duplico/qc10/hardware/QC10 BOM.xlsx

Sheet: BOM 2A
QTY | Reference | Part | Package | Manufacturer | PN | Any? | Notes
1 | A1 | ANT | 5.1mm SMT | Linx | ANT-433-USP | N
1 | BT1 | AAA | 0.5 in | Keystone | 2479 | Y
1 | C1 | 2.2uF | 3216 (mm) | Kemmet | T491A225K016AT | Y
1 | C14 | 4.7nF | 3216(mm) | Vishay | VJ1206Y472KXQCW1BC | Y
2 | C15, R15 | 0 Ohm | 3216 (mm) | Vishay | CRCW12060000Z0EA | Y
1 | C2 | 10nF | 0603 (mm) | Kemmet | C0201C103K4PACTU | Y
1 | C3 | 220pF | 0603 (mm) | TDK | C0603X7R1E221M030BA | Y
1 | C5 | 47uF | 6.3 mm x 5.4 mm | Kemet | EEV476M035A9GAA | Y
1 | C4 | 0.1uF | 0603 (mm) | Kemet | T491A104M035AT | Y
8 | C6 - C13 | 0.1uF | 3216(mm) | Vishay | VJ1206Y104KXQCW1BC | Y
3 | D1, D7, D14 | Red LED | 0603 (mm) | Lite-On | LTST-C193KRKT-5A | Y
1 | D13 | RGB LED | PLCC-6 | Avago | ASMT-YTB2-0BB02 | Y
1 | D15 | 0.5A | 3216(mm) | Schottky | SD1206S040S | Y
2 | D2, D8 | Ong LED | 0603 (mm) | Lite-On | LTST-C193KFKT-5A | Y
2 | D3, D9 | Yel LED | 0603 (mm) | Lite-On | LTST-C193KSKT-5A | Y
2 | D4, D10 | Grn LED | 0603 (mm) | Lite-On | LTST-C193KGKT-5A | Y
2 | D5, D11 | Blu LED | 0603 (mm) | Lite-On | LTST-C194TBKT | Y
2 | D6, D12 | Pink LED | 0603 (mm) | Panasonic | LNJP12X8ARA | N
0 | L1 |  | 1608 (mm) | Taiyo Yuden | HK16083N9S-T | Y | DNP/DNI
1 | MK1 | 2.2k | 4mm | PUI | TOM-1545P-R | N
2 | P1, P2 | 2x8 | 2 mm | 3M | 961208-6404-AR | Y | DNI
1 | P3 | 1x8 | 2mm | Harwin | M22-2010846 | Y | DNI
1 | R1 | 10k | 3216 (mm) | Vishay | CRCW120610K0FKEA | Y
3 | R2, R3, R4 | 2.2k | 3216 mm | Vishay | CRCW12062K20FKEA | Y
1 | U1 | Atmel MCU | TQFP-32 | Atmel | ATmega328P-AU | N
1 | U2 | 433Mhz | SOP-14 | HopeRF | RFM12B-433S2 | N | Customer Supplied
1 | U3 | LED Controler | HTSSOP-28 | TI | TLC5940PWP | N
1 | U4 | 22db Amp | SC-70 | Maxim | MAX9812 | N
1 | VR1 | 3.3v Reg | SOT 223-4 | TI | UA78M05CDCYR | Y
1 | X1 | 16 MHz Xt | 5mm | ECS | X908-ND | N

Sheet: Copy of Sheet1
Designator | Manufacturer | PN | Footprint | QTY | Price | Price QTY | Extended Pice | Voltage | Current | Power | Notes
U1 | Atmel | ATmega328P-AU | TQFP-32 | 1 | 1.73 | 100 | 1.73
U2 | HopeRF | RFM12B-433S2 | SOP-14 | 1 | 3.3 | 100 | 3.3
U3 | TI | TLC5940PWP | HTSSOP-28 | 1 | 1.82 | 100 | 1.82
D1, D7, D14 | Lite-On | LTST-C193KRKT-5A | 0603 (mm) | 3 | 0.078 | 100 | 0.234 | 1.85 |  |  | 10mcd
D2, D8 | Lite-On | LTST-C193KFKT-5A | 0603 (mm) | 2 | 0.25 | 100 | 0.5 | 1.95 |  |  | 21mcd
D3, D9 | Lite-On | LTST-C193KSKT-5A | 0603 (mm) | 2 | 0.25 | 100 | 0.5 | 1.95 |  |  | 16mcd, Amber
D4, D10 | Lite-On | LTST-C193KGKT-5A | 0603 (mm) | 2 | 0.65 | 100 | 1.3 | 2.9 |  |  | 40mcd
D5, D11 | Lite-On | LTST-C194TBKT | 0603 (mm) | 2 | 0.42 | 100 | 0.84 | 2.9 |  |  | 11.5mcd
D6, D12 | Panasonic | LNJP12X8ARA | 0603 (mm) | 2 | 0.32 | 100 | 0.64 | 2.9V
D13 | Avago | ASMT-YTB2-0BB02 | PLCC-6 | 1 | 1 | 100 | 1
Battery | N/A | N/A | 3AAA | 3 | 0.56 | 300 | 1.68
X1 | ECS | X908-ND | TH | 1 | 0.35 | 100 | 0.35
VR1 | TI | UA78M05CDCYR | SOT 223-4 | 1 | 0.43 | 100 | 0.43
C2, C3 | Kemmet | C0201C103K4PACTU | 0603 (mm) | 2 | 0.02 | 100 | 0.04
C1 | Kemmet | T491A225K016AT | 3216 MM | 1 | 0.15 | 100 | 0.15
C6 - C13 | Vishay | VJ1206Y104KXQCW1BC | 3216(mm) | 8 | 0.064 | 100 | 0.512
C5 | Kemmet | EEV476M035A9GAA | 6.3 mm x 5.4 mm | 1 | 0.177 | 100 | 0.177
P2, SPI | 3M | 951208-2520-AR-PR | 2 mm | 2 | 0.66 | 200
B1 | Keystone | 2479 |  | 1 | 1.77 | 100 | 1.77
R2, R3 | Vishay | CRCW12062K20FKEA | 3216 mm | 2 | 0.031 | 100 | 0.062
U4 | Maxim | MAX9812 | SC-70 | 1 | 0.5 | 100 | 0.5
A1 | Yageo | ANT1204F002R0433A | SM | 1 | 0.72 | 100 | 0.72
C14 | Vishay | VJ1206Y472KXQCW1BC | 3216 | 1 | 0.031 | 100 | 0.031
D15 | Schottky | SD1206S040S | 3216 | 1 | 0.213 | 100 | 0.213
MK1 | PUI | POM3542PR | 4mm | 1 | 1.01 | 100 | 1.01
P3 | Harwin | M22-2010846 | 2mm (1x8) | 1 | 0.26 | 100 | 0.26
L1 |  | HK16083N9S-T | 1608 (mm) | 1 | 0.1 | 100 | 0.1
 |  |  |  |  |  |  | $19.87

Sheet: Copy of Copy of Sheet1
QTY | PN | Designator
2 | LTST-C193KSKT-5A | D3, D9
2 | LTST-C193KGKT-5A | D4, D10
2 | LTST-C194TBKT | D5, D11
2 | LNJP12X8ARA | D6, D12
1 | ASMT-YTB2-0BB02 | D13
3 | N/A | Battery
1 | X908-ND | X1
1 | UA78M05CDCYR | VR1
2 | C0201C103K4PACTU | C2, C3
1 | T491A225K016AT | C1
8 | VJ1206Y104KXQCW1BC | C6 - C13
1 | EEV476M035A9GAA | C5
2 | 951208-2520-AR-PR | P2, SPI
1 | 2479 | B1
2 | CRCW12062K20FKEA | R2, R3
1 | MAX9812LEXT+T | U4
1 | ANT1204F002R0433A | A1
1 | VJ1206Y472KXQCW1BC | C14
1 | SD1206S040S | D15
1 | POM3542PR | MK1
1 | M22-2010846 | P3
1 | HK16083N9S-T | L1

Sheet: Sheet1
Part | Manufacturer | PN |  | Footprint | QTY | Price | Price QTY | Voltage | Current | Power | Notes
MCU | Atmel | ATmega328P-AU |  |  | 1 | 1.6 | 100
Wireless Module | Happy RF (lets say) |  |  |  | 1 | 5.56 | 100
LED Driver | TI | TLC5941PWP or W2RF002RF | TLC5940PWP |  | 1 | 1.36 | 100
Red LED | Panasonic | LNJ214R82RA | LTST-C193KRKT-5A | 0603 (mm) | 2 | 0.28 | 100 | 1.85 |  |  | 10mcd
Orange LED | Panasonic | LNJ812K87RA | LTST-C193KFKT-5A | 0603 (mm) | 2 | 0.25 | 100 | 1.95 |  |  | 21mcd
Yellow LED | Panasonic | LNJ414K82RA | LTST-C193KSKT-5A | 0603 (mm) | 2 | 0.25 | 100 | 1.95 |  |  | 16mcd, Amber
Green LED | Panasonic | LNJ626W8CRA |  | 0603 (mm) | 2 | 0.65 | 100 | 2.9 |  |  | 40mcd
Blue LED | Panasonic | LNJ926W8CRA |  | 0603 (mm) | 2 | 0.42 | 100 | 2.9 |  |  | 11.5mcd
Violet LED | Panasonic | LNJP12X8ARA | SMLD12HBC7W1 | 0603 (mm) | 2 | 0.32 | 100 | 2.9V
RGB LED | Avago | ASMT-YTB2-0BB02 |  |  | 1 |  | 100
Battery |  |  |  | 3AAA
Crystal |  | X908-ND
Regulator | TI | UA78M05CDCYR |  |  |  | 0.22
c2, c3 | Kemmet | C0201C103K4PACTU |  |  |  | 0.02
C1 | Kemmet | T491A225K016AT
0.1u | Kemmet | C1206C104K4RACTU
C5 | Kemmet | EEV476M035A9GAA
P1-P3 | 3M | 951208-2520-AR-PR
B1 | Keystonw | 2479 | http://www.digikey.com/product-detail/en/2479/2479K-ND/303824
R2, R3 | Vishay | CRCW12062K20FKEA

Sheet: Sheet2
Red LED | Panasonic | LNJ214R82RA | LTST-C193KRKT-5A | 2 | 0.28 | 100 | 1.85 | 10mcd
Orange LED | Panasonic | LNJ812K87RA | LTST-C193KFKT-5A | 2 | 0.25 | 100 | 1.95 | 21mcd
Yellow LED | Panasonic | LNJ414K82RA | LTST-C193KSKT-5A | 2 | 0.25 | 100 | 1.95 | 16mcd, Amber
Green LED | Panasonic | LNJ626W8CRA |  | 2 | 0.65 | 100 | 2.9 | 40mcd
Blue LED | Panasonic | LNJ926W8CRA |  | 2 | 0.42 | 100 | 2.9 | 11.5mcd
Violet LED | Panasonic | LNJP12X8ARA |  | 2 | 0.32 | 100 | 2.9V
RGB LED |  |  |  | 1 |  | 100

Sheet: Sheet3
BT1 | Keystone | Battery; 2 Leads | BAT-2 | 2479 | * | QTY
C1 | Kemmet | Chip Capacitor | 3216 (1210) | T491A225K016AT | 2.2uF | 1
C2 | Kemmet | Chip Capacitor | 0603 (mm) | C0201C103K4PACTU | 10nF | 1
C3 | AVX | Chip Capacitor | 0603 (mm) | CU0131220JAT2A\5K | 220pF | 1
C4 | Kemmet | Chip Capacitor | 3216 (1210) | C1206C104K4RACTU | 0.1uF | 1
C5 | Kemmet | Chip Capacitor | 6.3x5.4mm | EEV476M035A9GAA | 47uF | 1
C6 | Kemmet | Chip Capacitor | 3216 (1210) | C1206C104K4RACTU | 0.1uF | 1
C7 | Kemmet | Chip Capacitor | 3216 (1210) | C1206C104K4RACTU | 0.1uF | 1
C8 | Kemmet | Chip Capacitor | 3216 (1210) | C1206C104K4RACTU | 0.1uF | 1
C9 | Kemmet | Chip Capacitor | 3216 (1210) | C1206C104K4RACTU | 0.1uF | 1
C10 | Kemmet | Chip Capacitor | 3216 (1210) | C1206C104K4RACTU | 0.1uF | 1
C11 | Kemmet | Chip Capacitor | 3216 (1210) | C1206C104K4RACTU | 0.1uF | 1
C12 | Kemmet | Chip Capacitor | 3216 (1210) | C1206C104K4RACTU | 0.1uF | 1
C13 | Kemmet | Chip Capacitor | 3216 (1210) | C1206C104K4RACTU | 0.1uF | 1
D1 | Lite-On | SM LED; 2 Flat Leads | 0603 (mm) | LTST-C193KRKT-5A | Red | 1
D2 | Lite-On | SM LED; 2 Flat Leads | 0603 (mm) | LTST-C193KFKT-5A | Orange | 1
D3 | Lite-On | SM LED; 2 Flat Leads | 0603 (mm) | LTST-C193KSKT-5A | Yellow | 1
D4 | Lite-On | SM LED; 2 Flat Leads | 0603 (mm) | LTST-C193KGKT-5A | Green | 1
D5 | Lite-On | SM LED; 2 Flat Leads | 0603 (mm) | LTST-C194TBKT | Blue | 1
D6 | Panasonic | SM LED; 2 Flat Leads | 0603 (mm) | LNJP12X8ARA | Pink | 1
D7 | Lite-On | SM LED; 2 Flat Leads | 0603 (mm) | LTST-C193KRKT-5A | Red | 1
D8 | Lite-On | SM LED; 2 Flat Leads | 0603 (mm) | LTST-C193KFKT-5A | Orange | 1
D9 | Lite-On | SM LED; 2 Flat Leads | 0603 (mm) | LTST-C193KSKT-5A | Yellow | 1
D10 | Lite-On | SM LED; 2 Flat Leads | 0603 (mm) | LTST-C193KGKT-5A | Green | 1
D11 | Lite-On | SM LED; 2 Flat Leads | 0603 (mm) | LTST-C194TBKT | Blue | 1
D12 | Panasonic | SM LED; 2 Flat Leads | 0603 (mm) | LNJP12X8ARA | Pink | 1
D13 | Avago | * | PLCC-6 | ASMT-YTB2-0BB02 | RGB | 1
D14 | Lite-On | SM LED; 2 Flat Leads; RED | LTST-C193KRKT-5A | LTST-C193KRKT-5A | Red | 1
D15 | Vishay |  | SOD-123 | 1N4148W-V-GS18 | * | 1
MK1 |  | * | PIN2 |  | * | 1
P1 | 3M | 2mm 2x4 | * | 951208-2520-AR-PR | * | 1
P2 | Harwin | 2mm 1x8 | * | M22-2010846 | * | 1
P3 | Harwin | 2mm 1x8 | * | M22-2010846 | * | 1
R1 | KOA | Chip Resistor | 0603 (mm) | RK73B2BTTD103J | 10K | 1
R2 | Panasonic | Chip Resistor | 0603 (mm) | ERJ-T08J222V | 2.2K | 1
R3 | Panasonic | Chip Resistor | 0603 (mm) | ERJ-T08J222V | 2.2K | 1
R? | Panasonic | Chip Resistor | 0603 (mm) | ERJ-T08J222V | 2.2K | 1
SPI/ISP | 3M | 2mm 2x4 | * | 951208-2520-AR-PR | * | 1
U1 | Atmel | 32-Lead, 7x7x1.0 mm Body, 0.8mm Lead Pitch, Thin Profile Plastic Quad Flat Package (TQFP) | TQFP-32 | ATmega328P-AU | * | 1
U2 | HopeRF |  | SOP-14 | RFM12B-433S2 | * | 1
U3 | TI |  | HTSSPO-28 | TLC5940PWP | * | 1
U4 | Maxim |  | SC-70 | MAX9812 | * | 1
VR1 | TI | 3-Pin Transistor Outline Package 2.54 mm Pitch, 15.1 mm Lead Span | D2PAK | UA78M05CDCYR | * | 1
X1 | ECS | * | 5x10mm | X908-ND | * | 1
