duplico/qc10/hardware/QC10 Schematics Rev2A.PDF

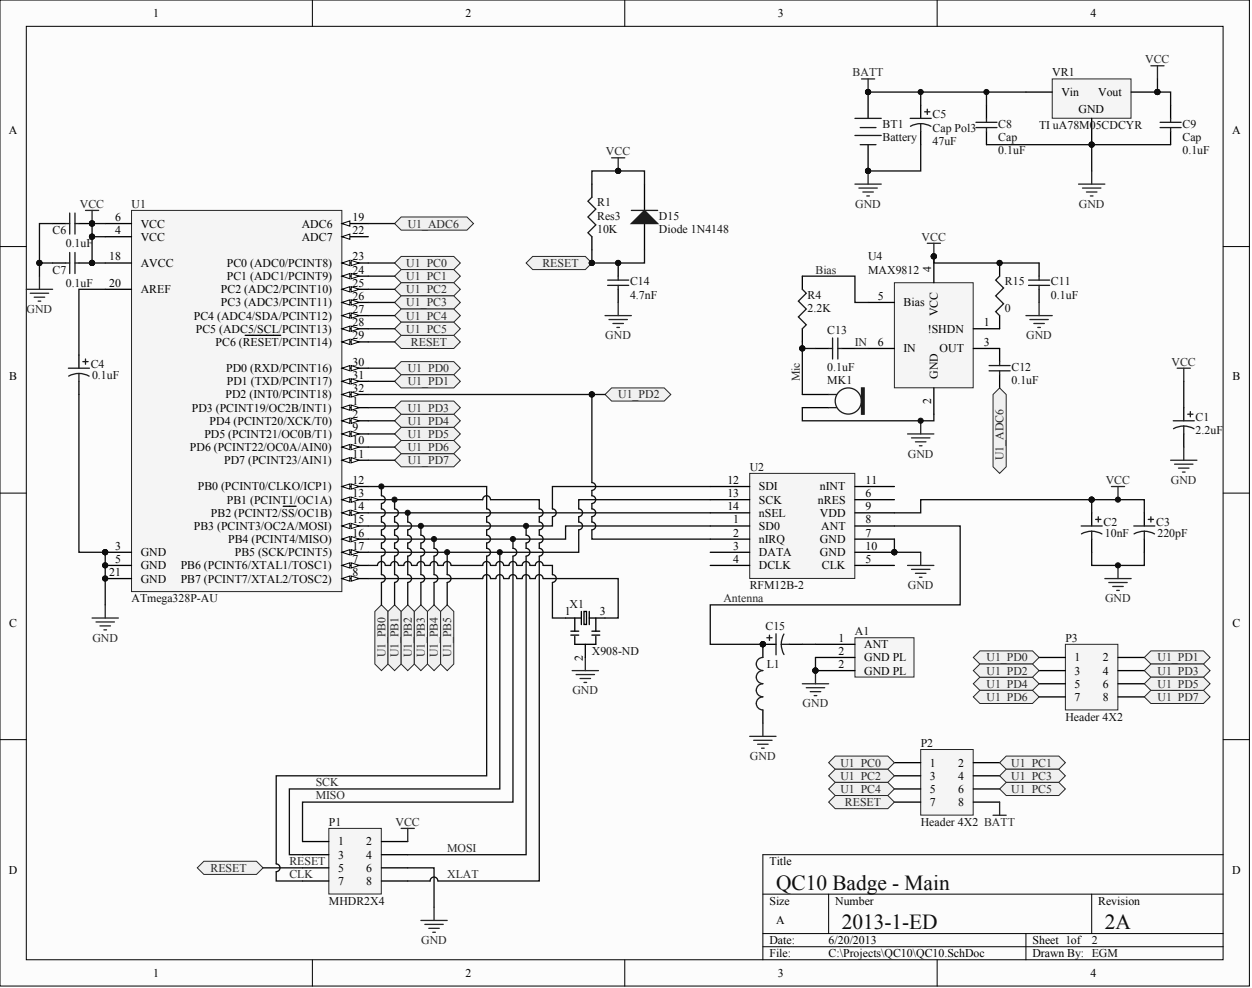
[picture p1: page 1]

SCK 13

GND 3

DATA 3

VCC

3 4 | | MOSI

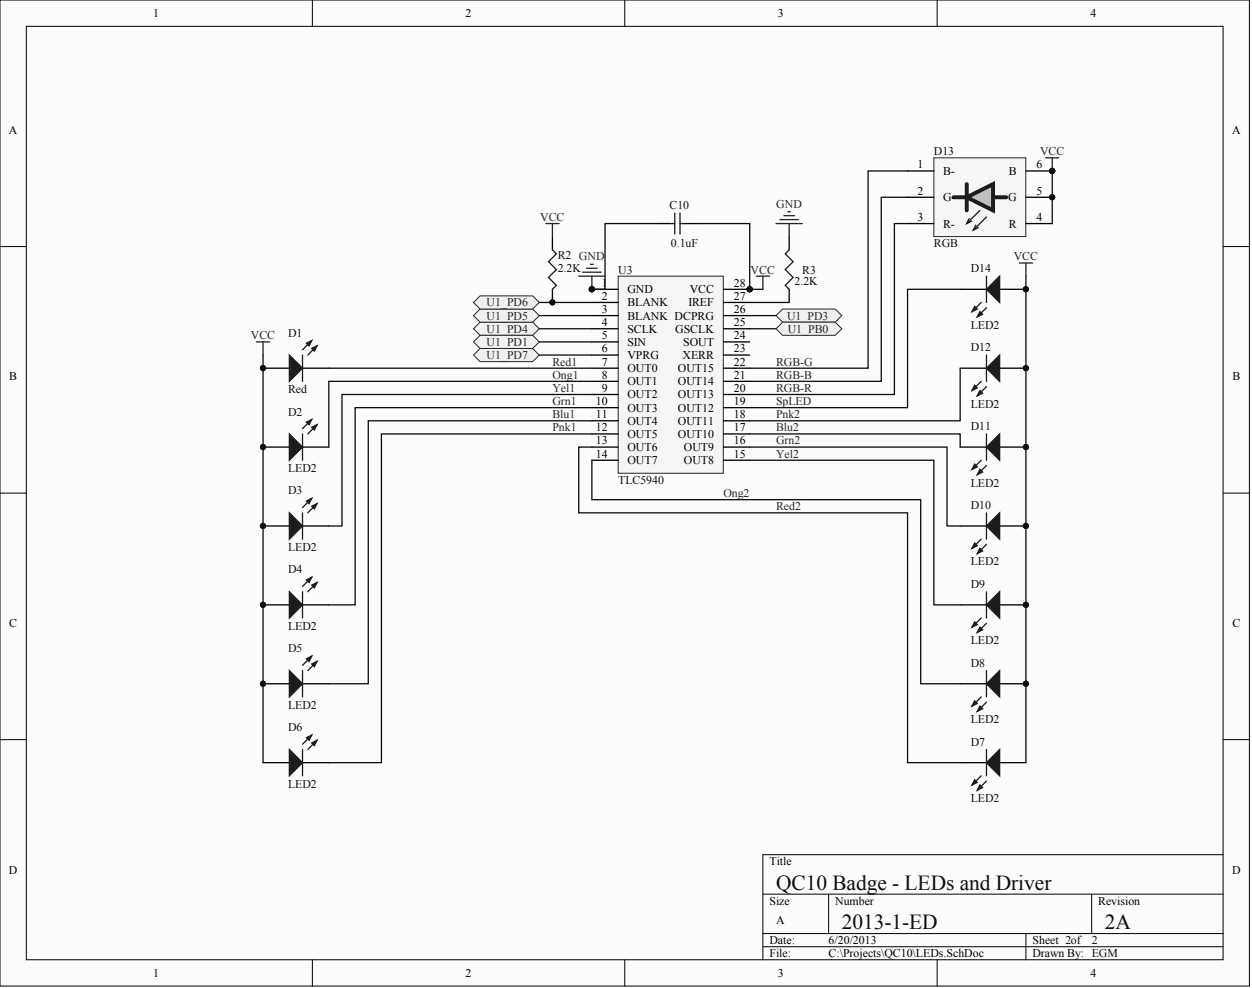
[picture p2: page 2]

GND VCC R3 | R- 3

Ong1 | OUT1 8 | | RGB-B | | D11
Yel1 | | OUT2 9 | | RGB-R
Grn1 | | OUT3 10 | | SpLED
Blu1 | | OUT4 11 | | Pnk2
Pnk1 | | OUT5 12 | Blu2

OUT6 13 | | Grn2

Title
QC10 Badge - LEDs and Driver

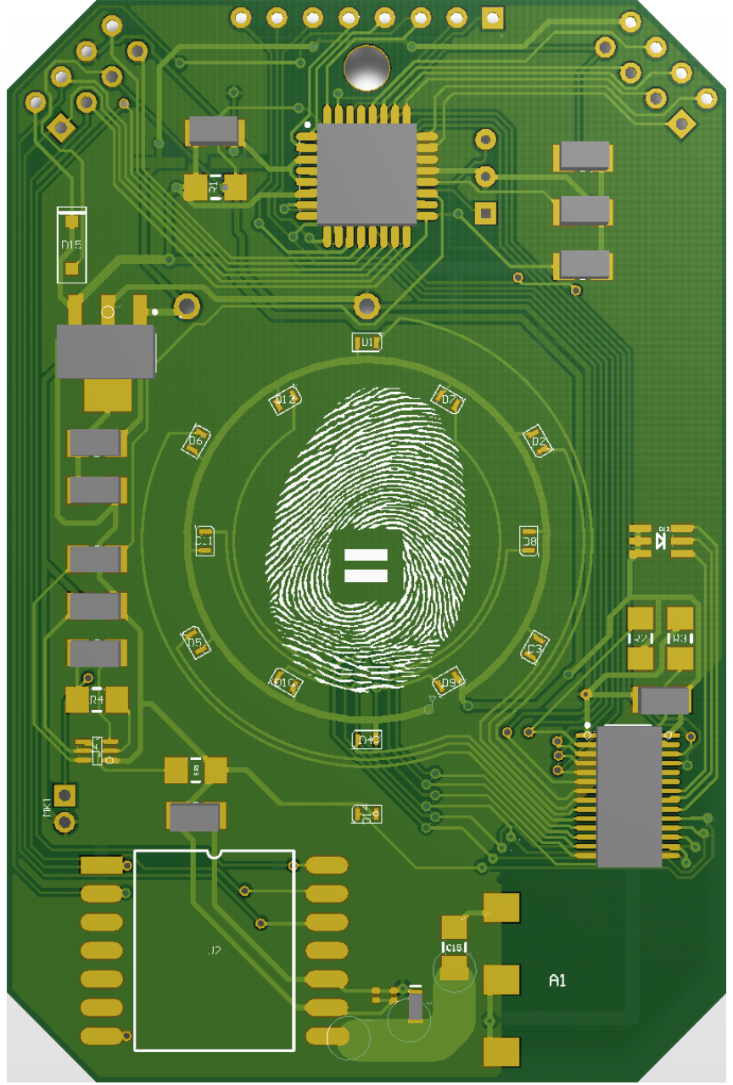
[picture p3: page 3]

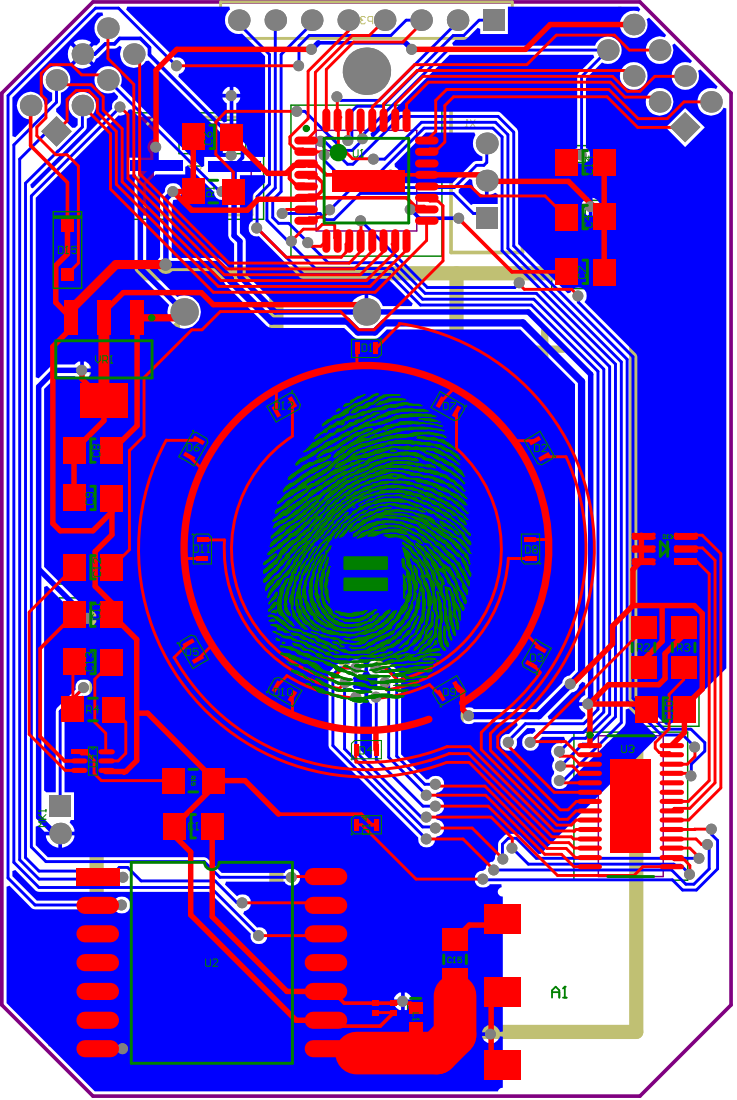
[picture p4: page 4]
