duplico/qc10/animations.c

#include <stdint.h>
#include <avr/io.h>
#include <avr/interrupt.h>
#include <avr/pgmspace.h>
#include <util/delay.h>

#include "tlc5940.h"
#include "animations.h"

#define COUNT_INTENSITY 100
#define BLING_INTENSITY 30

#define UBER_BRIGHT 15
#define UBER_DIM 8

QCSys heartbeats[][4] = {
  {{38, 0, 0, 0, 100}, // Red, .2/5.0sec
   {0, 0, 0, 0, 100},
   {38, 0, 0, 0, 100},
   {0, 0, 0, 0, 5000}},
   
  {{35, 12, 0, 0, 100}, // Orange, .2/2.0sec
   {0, 0, 0, 0, 100},
   {35, 12, 0, 0, 100},
   {0, 0, 0, 0, 2000}},
   
  {{28, 18, 0, 0, 100}, // Yellow, .2/1.5sec
   {0, 0, 0, 0, 100},
   {28, 18, 0, 0, 100},
   {0, 0, 0, 0, 1500}},
   
  {{0, 33, 0, 0, 100}, // Green, .15/1.0sec
   {0, 0, 0, 0, 100},
   {0, 33, 0, 0, 100},
   {0, 0, 0, 0, 1000}},
   
  {{0, 0, 33, 0, 100}, // Blue, .15/0.6sec
   {0, 0, 0, 0, 100},
   {0, 0, 33, 0, 100},
   {0, 0, 0, 0, 600}},
   
  {{20, 0, 24, 0, 100}, // Violet, .125/0.4sec
   {0, 0, 0, 0, 100},
   {20, 0, 24, 0, 100},
   {0, 0, 0, 0, 400}},
   
  {{33, 0, 18, 0, 100}, // Pink, .1/0.25sec
   {0, 0, 0, 0, 100},
   {33, 0, 18, 0, 100},
   {0, 0, 0, 0, 250}},
   
  {{0, 0, 0, 33, 25000}, // SPECIAL: PREBOOT
   {0, 0, 0, 0, 50},
   {0, 0, 0, 33, 25000},
   {0, 0, 0, 0, 50}},
   
  {{24, 24, 24, 0, 90}, // SPECIAL: NEWBADGESYS
   {0, 0, 0, 0, 90},
   {24, 24, 24, 0, 90},
   {0, 0, 0, 0, 90}},
   
  {{96, 96, 96, 0, 10}, // SPECIAL: PARTY 9
   {0, 0, 0, 0, 90},
   {0, 0, 0, 0, 0},
   {0, 0, 0, 0, 0}},
   
  {{0, 0, 0, 24, 10}, // SPECIAL: RECV 10
   {0, 0, 0, 0, 90},
   {0, 0, 0, 0, 0},
   {0, 0, 0, 0, 0}},
   
  {{24, 24, 24, 33, 10}, // SPECIAL: BLINK PREBOOT 11
   {0, 0, 0, 33, 25000},
   {0, 0, 0, 33, 0},
   {0, 0, 0, 33, 0}},
   
  {{0, 0, 0, 0, 1000}, // SPECIAL: BLANK SYSTEM 12
   {0, 0, 0, 0, 1000},
   {0, 0, 0, 0, 1000},
   {0, 0, 0, 0, 1000}},
};

// EFFECT: teardrop
#define QCR_DELAY 90
#define BLING1LEN 15
QCRing bling1[] PROGMEM = {
  {0, 0, 0, 0, 0, 0,
   0, 0, 0, 0, 0, 0,
   QCR_DELAY},
  {BLING_INTENSITY, 0, 0, 0, 0, 0,
   0, 0, 0, 0, 0, 0,
   QCR_DELAY},
  {0, 0, 0, 0, 0, 0,
   BLING_INTENSITY, 0, 0, 0, 0, BLING_INTENSITY,
   QCR_DELAY},
  {0, BLING_INTENSITY, 0, 0, 0, BLING_INTENSITY,
   0, 0, 0, 0, 0, 0,
   QCR_DELAY},
  {0, 0, 0, 0, 0, 0,
   0, BLING_INTENSITY, 0, 0, BLING_INTENSITY, 0,
   QCR_DELAY},
  {0, 0, BLING_INTENSITY, 0, BLING_INTENSITY, 0,
   0, 0, 0, 0, 0, 0,
   QCR_DELAY},
  {0, 0, 0, 0, 0, 0,
   0, 0, BLING_INTENSITY, BLING_INTENSITY, 0, 0,
   QCR_DELAY},
  {0, 0, 0, BLING_INTENSITY, 0, 0,
   0, 0, 0, 0, 0, 0,
   QCR_DELAY},
  {0, 0, 0, 0, 0, 0,
   0, 0, BLING_INTENSITY, BLING_INTENSITY, 0, 0,
   QCR_DELAY},
  {0, 0, BLING_INTENSITY, 0, BLING_INTENSITY, 0,
   0, 0, 0, 0, 0, 0,
   QCR_DELAY},
  {0, 0, 0, 0, 0, 0,
   0, BLING_INTENSITY, 0, 0, BLING_INTENSITY, 0,
   QCR_DELAY},
  {0, BLING_INTENSITY, 0, 0, 0, BLING_INTENSITY,
   0, 0, 0, 0, 0, 0,
   QCR_DELAY},
  {0, 0, 0, 0, 0, 0,
   BLING_INTENSITY, 0, 0, 0, 0, BLING_INTENSITY,
   QCR_DELAY},
  {BLING_INTENSITY, 0, 0, 0, 0, 0,
   0, 0, 0, 0, 0, 0,
   QCR_DELAY},
  {0, 0, 0, 0, 0, 0,
   0, 0, 0, 0, 0, 0,
   QCR_DELAY}
};

// EFFECT: Bouncing color pairs.
#define QCR_DELAY 90
#define BLING2LEN 14
QCRing bling2[] PROGMEM = {
  {0, 0, 0, 0, 0, 0,
   0, 0, 0, 0, 0, 0,
   QCR_DELAY},
  {0, BLING_INTENSITY, 0, 0, 0, 0,
   0, BLING_INTENSITY, 0, 0, 0, 0,
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
   0, 0, BLING_INTENSITY, 0, 0, 0,
   QCR_DELAY},
  {0, BLING_INTENSITY, 0, 0, 0, 0,
   0, BLING_INTENSITY, 0, 0, 0, 0,
   QCR_DELAY},
  {BLING_INTENSITY, 0, 0, 0, 0, 0,
   BLING_INTENSITY, 0, 0, 0, 0, 0,
   QCR_DELAY},
  {0, 0, 0, 0, 0, 0,
   0, 0, 0, 0, 0, 0,
   QCR_DELAY}
};

// EFFECT: Alternating opposite lights while spinning clockwise.
#define QCR_DELAY 90
#define BLING5LEN 16
QCRing bling5[] PROGMEM = {
  {0, 0, 0, 0, 0, 0,
   0, 0, 0, 0, 0, 0,
   QCR_DELAY},
  {BLING_INTENSITY, 0, 0, 0, 0, 0,
   0, 0, 0, 0, 0, 0,
   QCR_DELAY},
  {0, 0, 0, BLING_INTENSITY, 0, 0,
   0, 0, 0, 0, 0, 0,
   QCR_DELAY},
  {0, 0, 0, 0, 0, 0,
   BLING_INTENSITY, 0, 0, 0, 0, 0,
   QCR_DELAY},
  {0, 0, 0, 0, 0, 0,
   0, 0, 0, BLING_INTENSITY, 0, 0,
   QCR_DELAY},
  {0, BLING_INTENSITY, 0, 0, 0, 0,
   0, 0, 0, 0, 0, 0,
   QCR_DELAY},
  {0, 0, 0, 0, BLING_INTENSITY, 0,
   0, 0, 0, 0, 0, 0,
   QCR_DELAY},
  {0, 0, 0, 0, 0, 0,
   0, BLING_INTENSITY, 0, 0, 0, 0,
   QCR_DELAY},
  {0, 0, 0, 0, 0, 0,
   0, 0, 0, 0, BLING_INTENSITY, 0,
   QCR_DELAY},
  {0, 0, BLING_INTENSITY, 0, 0, 0,
   0, 0, 0, 0, 0, 0,
   QCR_DELAY},
  {0, 0, 0, 0, 0, BLING_INTENSITY,
   0, 0, 0, 0, 0, 0,
   QCR_DELAY},
  {0, 0, 0, 0, 0, 0,
   0, 0, BLING_INTENSITY, 0, 0, 0,
   QCR_DELAY},
  {0, 0, 0, 0, 0, 0,
   0, 0, 0, 0, 0, BLING_INTENSITY,
   QCR_DELAY},
  {0, 0, 0, BLING_INTENSITY, 0, 0,
   0, 0, 0, 0, 0, 0,
   QCR_DELAY},
  {BLING_INTENSITY, 0, 0, 0, 0, 0,
   0, 0, 0, 0, 0, 0,
   QCR_DELAY},
  {0, 0, 0, 0, 0, 0,
   0, 0, 0, 0, 0, 0,
   QCR_DELAY}
}; // bling5

// EFFECT: Ring light pairs toggle in/out while rotating counter-clockwise.
#define QCR_DELAY 90
#define BLING6LEN 14
QCRing bling6[] PROGMEM = {
  {0, 0, 0, 0, 0, 0,
   0, 0, 0, 0, 0, 0,
   QCR_DELAY},
  {BLING_INTENSITY, 0, 0, 0, 0, BLING_INTENSITY,
   0, 0, 0, 0, 0, 0,
   QCR_DELAY},
  {0, 0, 0, 0, 0, 0,
   0, 0, 0, 0, BLING_INTENSITY, BLING_INTENSITY,
   QCR_DELAY},
  {0, 0, 0, 0, BLING_INTENSITY, BLING_INTENSITY,
   0, 0, 0, 0, 0, 0,
   QCR_DELAY},
  {0, 0, 0, 0, 0, 0,
   0, 0, 0, BLING_INTENSITY, BLING_INTENSITY, 0,
   QCR_DELAY},
  {0, 0, 0, BLING_INTENSITY, BLING_INTENSITY, 0,
   0, 0, 0, 0, 0, 0,
   QCR_DELAY},
  {0, 0, 0, 0, 0, 0,
   0, 0, BLING_INTENSITY, BLING_INTENSITY, 0, 0,
   QCR_DELAY},
  {0, 0, BLING_INTENSITY, BLING_INTENSITY, 0, 0,
   0, 0, 0, 0, 0, 0,
   QCR_DELAY},
  {0, 0, 0, 0, 0, 0,
   0, BLING_INTENSITY, BLING_INTENSITY, 0, 0, 0,
   QCR_DELAY},
  {0, BLING_INTENSITY, BLING_INTENSITY, 0, 0, 0,
   0, 0, 0, 0, 0, 0,
   QCR_DELAY},
  {0, 0, 0, 0, 0, 0,
   BLING_INTENSITY, BLING_INTENSITY, 0, 0, 0, 0,
   QCR_DELAY},
  {BLING_INTENSITY, BLING_INTENSITY, 0, 0, 0, 0,
   0, 0, 0, 0, 0, 0,
   QCR_DELAY},
  {0, 0, 0, 0, 0, 0,
   BLING_INTENSITY, 0, 0, 0, 0, BLING_INTENSITY,
   QCR_DELAY},
  {0, 0, 0, 0, 0, 0,
   0, 0, 0, 0, 0, 0,
   QCR_DELAY}
}; //bling6

// EFFECT: Alternating top/bottom fill, then side/side.
#define QCR_DELAY 90
#define BLING7LEN 14
QCRing bling7[] PROGMEM = {
  {0, 0, 0, 0, 0, 0,
   0, 0, 0, 0, 0, 0,
   QCR_DELAY},
  {BLING_INTENSITY, 0, 0, 0, 0, 0,
   BLING_INTENSITY, 0, 0, 0, 0, BLING_INTENSITY,
   QCR_DELAY},
  {0, 0, 0, BLING_INTENSITY, 0, 0,
   0, 0, BLING_INTENSITY, BLING_INTENSITY, 0, 0,
   QCR_DELAY},
  {BLING_INTENSITY, 0, 0, 0, 0, 0,
   BLING_INTENSITY, 0, 0, 0, 0, BLING_INTENSITY,
   QCR_DELAY},
  {0, 0, 0, BLING_INTENSITY, 0, 0,
   0, 0, BLING_INTENSITY, BLING_INTENSITY, 0, 0,
   QCR_DELAY},
  {BLING_INTENSITY, 0, 0, 0, 0, 0,
   BLING_INTENSITY, 0, 0, 0, 0, BLING_INTENSITY,
   QCR_DELAY},
  {0, 0, 0, BLING_INTENSITY, 0, 0,
   0, 0, BLING_INTENSITY, BLING_INTENSITY, 0, 0,
   QCR_DELAY},
  {0, 0, 0, 0, BLING_INTENSITY, BLING_INTENSITY,
   0, 0, 0, 0, BLING_INTENSITY, 0,
   QCR_DELAY},
  {0, BLING_INTENSITY, BLING_INTENSITY, 0, 0, 0,
   0, BLING_INTENSITY, 0, 0, 0, 0,
   QCR_DELAY},
  {0, 0, 0, 0, BLING_INTENSITY, BLING_INTENSITY,
   0, 0, 0, 0, BLING_INTENSITY, 0,
   QCR_DELAY},
  {0, BLING_INTENSITY, BLING_INTENSITY, 0, 0, 0,
   0, BLING_INTENSITY, 0, 0, 0, 0,
   QCR_DELAY},
  {0, 0, 0, 0, BLING_INTENSITY, BLING_INTENSITY,
   0, 0, 0, 0, BLING_INTENSITY, 0,
   QCR_DELAY},
  {0, BLING_INTENSITY, BLING_INTENSITY, 0, 0, 0,
   0, BLING_INTENSITY, 0, 0, 0, 0,
   QCR_DELAY},
  {0, 0, 0, 0, 0, 0,
   0, 0, 0, 0, 0, 0,
   QCR_DELAY}
}; //bling7

// EFFECT: Two-light backward spin.
#define QCR_DELAY 90
#define BLING8LEN 16
QCRing bling8[] PROGMEM = {
  {0, 0, 0, 0, 0, 0,
   0, 0, 0, 0, 0, 0,
   QCR_DELAY},
  {BLING_INTENSITY, 0, 0, 0, 0, 0,
   0, 0, 0, 0, 0, 0,
   QCR_DELAY},
  {BLING_INTENSITY, 0, 0, 0, 0, 0,
   0, 0, 0, 0, 0, BLING_INTENSITY,
   QCR_DELAY},
  {0, 0, 0, 0, 0, BLING_INTENSITY,
   0, 0, 0, 0, 0, BLING_INTENSITY,
   QCR_DELAY},
  {0, 0, 0, 0, 0, BLING_INTENSITY,
   0, 0, 0, 0, BLING_INTENSITY, 0,
   QCR_DELAY},
  {0, 0, 0, 0, BLING_INTENSITY, 0,
   0, 0, 0, 0, BLING_INTENSITY, 0,
   QCR_DELAY},
  {0, 0, 0, 0, BLING_INTENSITY, 0,
   0, 0, 0, BLING_INTENSITY, 0, 0,
   QCR_DELAY},
  {0, 0, 0, BLING_INTENSITY, 0, 0,
   0, 0, 0, BLING_INTENSITY, 0, 0,
   QCR_DELAY},
  {0, 0, 0, BLING_INTENSITY, 0, 0,
   0, 0, BLING_INTENSITY, 0, 0, 0,
   QCR_DELAY},
  {0, 0, BLING_INTENSITY, 0, 0, 0,
   0, 0, BLING_INTENSITY, 0, 0, 0,
   QCR_DELAY},
  {0, 0, BLING_INTENSITY, 0, 0, 0,
   0, BLING_INTENSITY, 0, 0, 0, 0,
   QCR_DELAY},
  {0, BLING_INTENSITY, 0, 0, 0, 0,
   0, BLING_INTENSITY, 0, 0, 0, 0,
   QCR_DELAY},
  {0, BLING_INTENSITY, 0, 0, 0, 0,
   BLING_INTENSITY, 0, 0, 0, 0, 0,
   QCR_DELAY},
  {BLING_INTENSITY, 0, 0, 0, 0, 0,
   BLING_INTENSITY, 0, 0, 0, 0, 0,
   QCR_DELAY},
  {BLING_INTENSITY, 0, 0, 0, 0, 0,
   0, 0, 0, 0, 0, 0,
   QCR_DELAY},
  {0, 0, 0, 0, 0, 0,
   0, 0, 0, 0, 0, 0,
   QCR_DELAY}
}; // bling8

// EFFECT: Outer spin then inner spin.
#define QCR_DELAY 90
#define BLING9LEN 15
QCRing bling9[] PROGMEM = {
  {0, 0, 0, 0, 0, 0,
   0, 0, 0, 0, 0, 0,
   QCR_DELAY},
  {BLING_INTENSITY, 0, 0, 0, 0, 0,
   0, 0, 0, 0, 0, 0,
   QCR_DELAY},
  {BLING_INTENSITY, BLING_INTENSITY, 0, 0, 0, 0,
   0, 0, 0, 0, 0, 0,
   QCR_DELAY},
  {0, BLING_INTENSITY, BLING_INTENSITY, 0, 0, 0,
   0, 0, 0, 0, 0, 0,
   QCR_DELAY},
  {0, 0, BLING_INTENSITY, BLING_INTENSITY, 0, 0,
   0, 0, 0, 0, 0, 0,
   QCR_DELAY},
  {0, 0, 0, BLING_INTENSITY, BLING_INTENSITY, 0,
   0, 0, 0, 0, 0, 0,
   QCR_DELAY},
  {0, 0, 0, 0, BLING_INTENSITY, BLING_INTENSITY,
   0, 0, 0, 0, 0, 0,
   QCR_DELAY},
  {0, 0, 0, 0, 0, BLING_INTENSITY,
   BLING_INTENSITY, 0, 0, 0, 0, 0,
   QCR_DELAY},
  {0, 0, 0, 0, 0, 0,
   BLING_INTENSITY, BLING_INTENSITY, 0, 0, 0, 0,
   QCR_DELAY},
  {0, 0, 0, 0, 0, 0,
   0, BLING_INTENSITY, BLING_INTENSITY, 0, 0, 0,
   QCR_DELAY},
  {0, 0, 0, 0, 0, 0,
   0, 0, BLING_INTENSITY, BLING_INTENSITY, 0, 0,
   QCR_DELAY},
  {0, 0, 0, 0, 0, 0,
   0, 0, 0, BLING_INTENSITY, BLING_INTENSITY, 0,
   QCR_DELAY},
  {0, 0, 0, 0, 0, 0,
   0, 0, 0, 0, BLING_INTENSITY, BLING_INTENSITY,
   QCR_DELAY},
  {0, 0, 0, 0, 0, 0,
   0, 0, 0, 0, 0, BLING_INTENSITY,
   QCR_DELAY},
  {0, 0, 0, 0, 0, 0,
   0, 0, 0, 0, 0, 0,
   QCR_DELAY}
}; //bling9

// EFFECT: 
#define QCR_DELAY 90
#define BLING10LEN 11
QCRing bling10[] PROGMEM = {
  {0, 0, 0, 0, 0, 0,
   0, 0, 0, 0, 0, 0,
   QCR_DELAY},
  {0, 0, 0, 0, BLING_INTENSITY, 0,
   0, 0, 0, 0, 0, 0,
   QCR_DELAY},
  {0, 0, 0, 0, BLING_INTENSITY, 0,
   0, 0, 0, BLING_INTENSITY, BLING_INTENSITY, 0,
   QCR_DELAY},
  {0, 0, 0, 0, 0, 0,
   BLING_INTENSITY, BLING_INTENSITY, 0, 0, 0, 0,
   QCR_DELAY},
  {0, BLING_INTENSITY, 0, 0, 0, 0,
   0, 0, 0, 0, 0, 0,
   QCR_DELAY},
  {0, 0, 0, 0, 0, 0,
   0, 0, 0, 0, 0, 0,
   QCR_DELAY},
  {0, 0, BLING_INTENSITY, 0, 0, 0,
   0, 0, 0, 0, 0, 0,
   QCR_DELAY},
  {0, 0, 0, 0, 0, 0,
   0, BLING_INTENSITY, BLING_INTENSITY, 0, 0, 0,
   QCR_DELAY},
  {0, 0, 0, 0, 0, 0,
   0, 0, 0, 0, BLING_INTENSITY, BLING_INTENSITY,
   QCR_DELAY},
  {0, 0, 0, 0, 0, BLING_INTENSITY,
   0, 0, 0, 0, 0, 0,
   QCR_DELAY},
  {0, 0, 0, 0, 0, 0,
   0, 0, 0, 0, 0, 0,
   QCR_DELAY}
}; //bling10

// EFFECT: Make it rain
#define QCR_DELAY 90
#define UBLING1LEN 21
QCRing ubling1[] PROGMEM = {
  {0, 0, 0, 0, 0, 0,
   0, 0, 0, 0, 0, 0,
   QCR_DELAY},
  {BLING_INTENSITY, 0, 0, 0, 0, 0,
   0, 0, 0, 0, 0, 0,
   QCR_DELAY},
  {BLING_INTENSITY, 0, 0, 0, 0, 0,
   0, 0, 0, 0, 0, BLING_INTENSITY,
   QCR_DELAY},
  {0, 0, 0, 0, 0, BLING_INTENSITY,
   0, 0, 0, 0, 0, BLING_INTENSITY,
   QCR_DELAY},
  {BLING_INTENSITY, 0, 0, 0, 0, BLING_INTENSITY,
   0, 0, 0, 0, BLING_INTENSITY, 0,
   QCR_DELAY},
  {BLING_INTENSITY, 0, 0, 0, BLING_INTENSITY, 0,
   BLING_INTENSITY, 0, 0, 0, BLING_INTENSITY, 0,
   QCR_DELAY},
  {0, BLING_INTENSITY, 0, 0, BLING_INTENSITY, 0,
   BLING_INTENSITY, 0, 0, BLING_INTENSITY, 0, 0,
   QCR_DELAY},
  {0, BLING_INTENSITY, 0, BLING_INTENSITY, 0, 0,
   0, BLING_INTENSITY, 0, BLING_INTENSITY, 0, 0,
   QCR_DELAY},
  {BLING_INTENSITY, 0, BLING_INTENSITY, BLING_INTENSITY, 0, 0,
   0, BLING_INTENSITY, 0, 0, 0, 0,
   QCR_DELAY},
  {BLING_INTENSITY, 0, BLING_INTENSITY, 0, 0, 0,
   0, 0, BLING_INTENSITY, 0, 0, BLING_INTENSITY,
   QCR_DELAY},
  {0, 0, 0, BLING_INTENSITY, 0, BLING_INTENSITY,
   0, 0, BLING_INTENSITY, 0, 0, BLING_INTENSITY,
   QCR_DELAY},
  {0, 0, 0, BLING_INTENSITY, 0, BLING_INTENSITY,
   0, 0, 0, 0, BLING_INTENSITY, 0,
   QCR_DELAY},
  {BLING_INTENSITY, 0, 0, 0, BLING_INTENSITY, 0,
   0, 0, 0, 0, BLING_INTENSITY, 0,
   QCR_DELAY},
  {BLING_INTENSITY, 0, 0, 0, BLING_INTENSITY, 0,
   BLING_INTENSITY, 0, 0, BLING_INTENSITY, 0, 0,
   QCR_DELAY},
  {0, BLING_INTENSITY, 0, BLING_INTENSITY, 0, 0,
   BLING_INTENSITY, 0, 0, BLING_INTENSITY, 0, 0,
   QCR_DELAY},
  {0, BLING_INTENSITY, 0, BLING_INTENSITY, 0, 0,
   0, BLING_INTENSITY, 0, 0, 0, 0,
   QCR_DELAY},
  {0, 0, BLING_INTENSITY, 0, 0, 0,
   0, BLING_INTENSITY, 0, 0, 0, 0,
   QCR_DELAY},
  {0, 0, BLING_INTENSITY, 0, 0, 0,
   0, 0, BLING_INTENSITY, 0, 0, 0,
   QCR_DELAY},
  {0, 0, 0, BLING_INTENSITY, 0, 0,
   0, 0, BLING_INTENSITY, 0, 0, 0,
   QCR_DELAY},
  {0, 0, 0, BLING_INTENSITY, 0, 0,
   0, 0, 0, 0, 0, 0,
   QCR_DELAY},
  {0, 0, 0, 0, 0, 0,
   0, 0, 0, 0, 0, 0,
   QCR_DELAY}
}; //ubling1

// EFFECT: Left-to-right swipe
#define QCR_DELAY 200
#define UBLING2LEN 11
QCRing ubling2[] PROGMEM = {
  {0, 0, 0, 0, 0, 0,
   0, 0, 0, 0, 0, 0,
   QCR_DELAY},
  {0, 0, 0, 0, 0, 0,
   0, 0, 0, 0, BLING_INTENSITY, 0,
   QCR_DELAY},
  {0, 0, 0, 0, BLING_INTENSITY, BLING_INTENSITY,
   0, 0, 0, 0, BLING_INTENSITY, 0,
   QCR_DELAY},
  {0, 0, 0, 0, BLING_INTENSITY, BLING_INTENSITY,
   0, 0, 0, BLING_INTENSITY, BLING_INTENSITY, BLING_INTENSITY,
   QCR_DELAY},
  {BLING_INTENSITY, 0, 0, BLING_INTENSITY, BLING_INTENSITY, BLING_INTENSITY,
   0, 0, 0, BLING_INTENSITY, 0, BLING_INTENSITY,
   QCR_DELAY},
  {BLING_INTENSITY, 0, 0, BLING_INTENSITY, 0, 0,
   BLING_INTENSITY, 0, BLING_INTENSITY, BLING_INTENSITY, 0, BLING_INTENSITY,
   QCR_DELAY},
  {BLING_INTENSITY, BLING_INTENSITY, BLING_INTENSITY, BLING_INTENSITY, 0, 0,
   BLING_INTENSITY, 0, BLING_INTENSITY, 0, 0, 0,
   QCR_DELAY},
  {0, BLING_INTENSITY, BLING_INTENSITY, 0, 0, 0,
   BLING_INTENSITY, BLING_INTENSITY, BLING_INTENSITY, 0, 0, 0,
   QCR_DELAY},
  {0, BLING_INTENSITY, BLING_INTENSITY, 0, 0, 0,
   0, BLING_INTENSITY, 0, 0, 0, 0,
   QCR_DELAY},
  {0, 0, 0, 0, 0, 0,
   0, BLING_INTENSITY, 0, 0, 0, 0,
   QCR_DELAY},
  {0, 0, 0, 0, 0, 0,
   0, 0, 0, 0, 0, 0,
   QCR_DELAY}
}; // ubling2

// EFFECT: Top/bottom alternate "ringing" look.
#define QCR_DELAY 45
#define UBLING3LEN 14
QCRing ubling3[] PROGMEM = {
  {0, 0, 0, 0, 0, 0,
   0, 0, 0, 0, 0, 0,
   QCR_DELAY},
  {BLING_INTENSITY, BLING_INTENSITY, 0, 0, 0, BLING_INTENSITY,
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
   0, BLING_INTENSITY, 0, 0, BLING_INTENSITY, 0,
   QCR_DELAY},
  {0, 0, 0, 0, 0, 0,
   0, BLING_INTENSITY, 0, 0, BLING_INTENSITY, 0,
   QCR_DELAY},
  {0, 0, 0, 0, 0, 0,
   0, 0, 0, 0, BLING_INTENSITY, 0,
   QCR_DELAY},
  {0, 0, 0, 0, 0, 0,
   0, 0, 0, 0, 0, 0,
   QCR_DELAY},
}; //ubling10


// REPEAT INDEFINITELY
// EFFECT: Single light bounce up and down on both sides
#define QCR_DELAY 20
#define UBER1LEN 5
QCRing uber1[] PROGMEM = {
  {UBER_BRIGHT, UBER_DIM, UBER_DIM, UBER_BRIGHT, UBER_DIM, UBER_DIM,
   UBER_DIM, UBER_DIM, UBER_DIM, UBER_DIM, UBER_DIM, UBER_DIM,
   QCR_DELAY},
  {UBER_DIM, UBER_DIM, UBER_DIM, UBER_DIM, UBER_DIM, UBER_DIM,
   UBER_BRIGHT, UBER_DIM, UBER_BRIGHT, UBER_BRIGHT, UBER_DIM, UBER_BRIGHT,
   QCR_DELAY},
  {UBER_DIM, UBER_BRIGHT, UBER_BRIGHT, UBER_DIM, UBER_BRIGHT, UBER_BRIGHT,
   UBER_DIM, UBER_DIM, UBER_DIM, UBER_DIM, UBER_DIM, UBER_DIM,
   QCR_DELAY},
  {UBER_DIM, UBER_DIM, UBER_DIM, UBER_DIM, UBER_DIM, UBER_DIM,
   UBER_DIM, UBER_BRIGHT, UBER_DIM, UBER_DIM, UBER_BRIGHT, UBER_DIM,
   QCR_DELAY},
  {UBER_DIM, UBER_BRIGHT, UBER_BRIGHT, UBER_DIM, UBER_BRIGHT, UBER_BRIGHT,
   UBER_DIM, UBER_DIM, UBER_DIM, UBER_DIM, UBER_DIM, UBER_DIM,
   QCR_DELAY},
  {UBER_DIM, UBER_DIM, UBER_DIM, UBER_DIM, UBER_DIM, UBER_DIM,
   UBER_BRIGHT, UBER_DIM, UBER_BRIGHT, UBER_BRIGHT, UBER_DIM, UBER_BRIGHT,
   QCR_DELAY}
}; //uber1

// REPEAT INDEFINITELY
// EFFECT: Two color pairs rotate in sequence
#define QCR_DELAY 90
#define UBER2LEN 3
QCRing uber2[] PROGMEM = {
  {UBER_BRIGHT, UBER_DIM, UBER_DIM, UBER_BRIGHT, UBER_DIM, UBER_DIM,
   UBER_BRIGHT, UBER_DIM, UBER_DIM, UBER_BRIGHT, UBER_DIM, UBER_DIM,
   QCR_DELAY},
  {UBER_DIM, UBER_DIM, UBER_BRIGHT, UBER_DIM, UBER_DIM, UBER_BRIGHT,
   UBER_DIM, UBER_DIM, UBER_BRIGHT, UBER_DIM, UBER_DIM, UBER_BRIGHT,
   QCR_DELAY},
  {UBER_DIM, UBER_BRIGHT, UBER_DIM, UBER_DIM, UBER_BRIGHT, UBER_DIM,
   UBER_DIM, UBER_BRIGHT, UBER_DIM, UBER_DIM, UBER_BRIGHT, UBER_DIM,
   QCR_DELAY}
}; //uber2

// EFFECT: Bouncing color pairs rotate counter-clockwise
// REPEAT INDEFINITELY
#define QCR_DELAY 90
#define UBER3LEN 12
QCRing uber3[] PROGMEM = {
  {UBER_BRIGHT, UBER_DIM, UBER_DIM, UBER_DIM, UBER_DIM, UBER_DIM,
   UBER_BRIGHT, UBER_DIM, UBER_DIM, UBER_DIM, UBER_DIM, UBER_DIM,
   QCR_DELAY},
  {UBER_DIM, UBER_DIM, UBER_DIM, UBER_BRIGHT, UBER_DIM, UBER_DIM,
   UBER_DIM, UBER_DIM, UBER_DIM, UBER_BRIGHT, UBER_DIM, UBER_DIM,
   QCR_DELAY},
  {UBER_DIM, UBER_BRIGHT, UBER_DIM, UBER_DIM, UBER_DIM, UBER_DIM,
   UBER_DIM, UBER_BRIGHT, UBER_DIM, UBER_DIM, UBER_DIM, UBER_DIM,
   QCR_DELAY},
  {UBER_DIM, UBER_DIM, UBER_DIM, UBER_DIM, UBER_BRIGHT, UBER_DIM,
   UBER_DIM, UBER_DIM, UBER_DIM, UBER_DIM, UBER_BRIGHT, UBER_DIM,
   QCR_DELAY},
  {UBER_DIM, UBER_DIM, UBER_BRIGHT, UBER_DIM, UBER_DIM, UBER_DIM,
   UBER_DIM, UBER_DIM, UBER_BRIGHT, UBER_DIM, UBER_DIM, UBER_DIM,
   QCR_DELAY},
  {UBER_DIM, UBER_DIM, UBER_DIM, UBER_DIM, UBER_DIM, UBER_BRIGHT,
   UBER_DIM, UBER_DIM, UBER_DIM, UBER_DIM, UBER_DIM, UBER_BRIGHT,
   QCR_DELAY},
  {UBER_DIM, UBER_DIM, UBER_DIM, UBER_BRIGHT, UBER_DIM, UBER_DIM,
   UBER_DIM, UBER_DIM, UBER_DIM, UBER_BRIGHT, UBER_DIM, UBER_DIM,
   QCR_DELAY},
  {UBER_BRIGHT, UBER_DIM, UBER_DIM, UBER_DIM, UBER_DIM, UBER_DIM,
   UBER_BRIGHT, UBER_DIM, UBER_DIM, UBER_DIM, UBER_DIM, UBER_DIM,
   QCR_DELAY},
  {UBER_DIM, UBER_DIM, UBER_DIM, UBER_DIM, UBER_BRIGHT, UBER_DIM,
   UBER_DIM, UBER_DIM, UBER_DIM, UBER_DIM, UBER_BRIGHT, UBER_DIM,
   QCR_DELAY},
  {UBER_DIM, UBER_BRIGHT, UBER_DIM, UBER_DIM, UBER_DIM, UBER_DIM,
   UBER_DIM, UBER_BRIGHT, UBER_DIM, UBER_DIM, UBER_DIM, UBER_DIM,
   QCR_DELAY},
  {UBER_DIM, UBER_DIM, UBER_DIM, UBER_DIM, UBER_DIM, UBER_BRIGHT,
   UBER_DIM, UBER_DIM, UBER_DIM, UBER_DIM, UBER_DIM, UBER_BRIGHT,
   QCR_DELAY},
  {UBER_DIM, UBER_DIM, UBER_BRIGHT, UBER_DIM, UBER_DIM, UBER_DIM,
   UBER_DIM, UBER_DIM, UBER_BRIGHT, UBER_DIM, UBER_DIM, UBER_DIM,
   QCR_DELAY}
}; //uber3

// EFFECT: Triangle bounce
#define QCR_DELAY 90
#define UBER4LEN 4
QCRing uber4[] PROGMEM = {
  {UBER_BRIGHT, UBER_DIM, UBER_BRIGHT, UBER_DIM, UBER_BRIGHT, UBER_DIM,
   UBER_DIM, UBER_DIM, UBER_DIM, UBER_DIM, UBER_DIM, UBER_DIM,
   QCR_DELAY},
  {UBER_DIM, UBER_BRIGHT, UBER_DIM, UBER_BRIGHT, UBER_DIM, UBER_BRIGHT,
   UBER_DIM, UBER_DIM, UBER_DIM, UBER_DIM, UBER_DIM, UBER_DIM,
   QCR_DELAY},
  {UBER_DIM, UBER_DIM, UBER_DIM, UBER_DIM, UBER_DIM, UBER_DIM,
   UBER_DIM, UBER_BRIGHT, UBER_DIM, UBER_BRIGHT, UBER_DIM, UBER_BRIGHT,
   QCR_DELAY},
  {UBER_DIM, UBER_DIM, UBER_DIM, UBER_DIM, UBER_DIM, UBER_DIM,
   UBER_BRIGHT, UBER_DIM, UBER_BRIGHT, UBER_DIM, UBER_BRIGHT, UBER_DIM,
   QCR_DELAY}
}; //uber4

// EFFECT: Rock back and forth
#define QCR_DELAY 90
#define UBER5LEN UBER_DIM
QCRing uber5[] PROGMEM = {
  {UBER_BRIGHT, UBER_BRIGHT, UBER_DIM, UBER_BRIGHT, UBER_BRIGHT, UBER_DIM,
   UBER_BRIGHT, UBER_DIM, UBER_DIM, UBER_BRIGHT, UBER_DIM, UBER_DIM,
   QCR_DELAY},
  {UBER_DIM, UBER_BRIGHT, UBER_DIM, UBER_DIM, UBER_BRIGHT, UBER_DIM,
   UBER_BRIGHT, UBER_BRIGHT, UBER_DIM, UBER_BRIGHT, UBER_BRIGHT, UBER_DIM,
   QCR_DELAY},
  {UBER_DIM, UBER_BRIGHT, UBER_BRIGHT, UBER_DIM, UBER_BRIGHT, UBER_BRIGHT,
   UBER_DIM, UBER_BRIGHT, UBER_DIM, UBER_DIM, UBER_BRIGHT, UBER_DIM,
   QCR_DELAY},
  {UBER_DIM, UBER_DIM, UBER_BRIGHT, UBER_DIM, UBER_DIM, UBER_BRIGHT,
   UBER_DIM, UBER_BRIGHT, UBER_BRIGHT, UBER_DIM, UBER_BRIGHT, UBER_BRIGHT,
   QCR_DELAY},
  {UBER_BRIGHT, UBER_DIM, UBER_BRIGHT, UBER_BRIGHT, UBER_DIM, UBER_BRIGHT,
   UBER_DIM, UBER_DIM, UBER_BRIGHT, UBER_DIM, UBER_DIM, UBER_BRIGHT,
   QCR_DELAY},
  {UBER_DIM, UBER_DIM, UBER_BRIGHT, UBER_DIM, UBER_DIM, UBER_BRIGHT,
   UBER_DIM, UBER_BRIGHT, UBER_BRIGHT, UBER_DIM, UBER_BRIGHT, UBER_BRIGHT,
   QCR_DELAY},
  {UBER_DIM, UBER_BRIGHT, UBER_BRIGHT, UBER_DIM, UBER_BRIGHT, UBER_BRIGHT,
   UBER_DIM, UBER_BRIGHT, UBER_DIM, UBER_DIM, UBER_BRIGHT, UBER_DIM,
   QCR_DELAY},
  {UBER_DIM, UBER_BRIGHT, UBER_DIM, UBER_DIM, UBER_BRIGHT, UBER_DIM,
   UBER_BRIGHT, UBER_BRIGHT, UBER_DIM, UBER_BRIGHT, UBER_BRIGHT, UBER_DIM,
   QCR_DELAY}

}; //uber5

// REPEAT INDEFINITELY
// EFFECT: Up/down swipe
#define QCR_DELAY 90
#define UBER6LEN 12
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
   QCR_DELAY},
  {0, 255, 0, 0, 255, 0,
   0, 255, 0, 0, 255, 0,
   QCR_DELAY},
  {0, 0, 255, 0, 0, 255,
   0, 255, 0, 0, 255, 0,
   QCR_DELAY},
  {0, 0, 255, 0, 0, 255,
   0, 0, 255, 0, 0, 255,
   QCR_DELAY},
  {255, 0, 0, 255, 0, 0,
   0, 0, 255, 0, 0, 255,
   QCR_DELAY},

  {255, 0, 0, 255, 0, 0,
   255, 0, 0, 255, 0, 0,
   QCR_DELAY},
  {0, 255, 0, 0, 255, 0,
   255, 0, 0, 255, 0, 0,
   QCR_DELAY},
  {0, 255, 0, 0, 255, 0,
   0, 255, 0, 0, 255, 0,
   QCR_DELAY},
  {0, 0, 255, 0, 0, 255,
   0, 255, 0, 0, 255, 0,
   QCR_DELAY},
  {0, 0, 255, 0, 0, 255,
   0, 0, 255, 0, 0, 255,
   QCR_DELAY},
  {255, 0, 0, 255, 0, 0,
   0, 0, 255, 0, 0, 255,
   QCR_DELAY},

  {255, 0, 0, 255, 0, 0,
   0, 0, 0, 0, 0, 0,
   QCR_DELAY},
  {0, 0, 0, 0, 0, 0,
   0, 0, 0, 0, 0, 0,
   QCR_DELAY}
}; //nearbadge

// EFFECT: alternate rings to show superuber at preboot
#define QCR_DELAY 90
#define SUPERUBERLEN 4
QCRing superuber[] PROGMEM = {
  {0, 0, 0, 0, 0, 0,
   0, 0, 0, 0, 0, 0,
   50},
  {64, 64, 64, 64, 64, 64,
   0, 0, 0, 0, 0, 0,
   500},
  {0, 0, 0, 0, 0, 0,
   64, 64, 64, 64, 64, 64,
   500},
  {0, 0, 0, 0, 0, 0,
   0, 0, 0, 0, 0, 0,
   50}
}; //superuber

#define QCR_DELAY 90
#define BADGECOUNTLEN 25
QCRing badgecount[] PROGMEM = {
  {0, 0, 0, 0, 0, 0,
   0, 0, 0, 0, 0, 0,
   QCR_DELAY},
  {COUNT_INTENSITY, 0, 0, 0, 0, 0,
   0, 0, 0, 0, 0, 0,
   QCR_DELAY},
  {COUNT_INTENSITY, 0, 0, 0, 0, 0,
   COUNT_INTENSITY, 0, 0, 0, 0, 0,
   QCR_DELAY},
  {COUNT_INTENSITY, COUNT_INTENSITY, 0, 0, 0, 0,
   COUNT_INTENSITY, 0, 0, 0, 0, 0,
   QCR_DELAY},
  {COUNT_INTENSITY, COUNT_INTENSITY, 0, 0, 0, 0,
   COUNT_INTENSITY, COUNT_INTENSITY, 0, 0, 0, 0,
   QCR_DELAY},
  {COUNT_INTENSITY, COUNT_INTENSITY, COUNT_INTENSITY, 0, 0, 0,
   COUNT_INTENSITY, COUNT_INTENSITY, 0, 0, 0, 0,
   QCR_DELAY},
  {COUNT_INTENSITY, COUNT_INTENSITY, COUNT_INTENSITY, 0, 0, 0,
   COUNT_INTENSITY, COUNT_INTENSITY, COUNT_INTENSITY, 0, 0, 0,
   QCR_DELAY},
  {COUNT_INTENSITY, COUNT_INTENSITY, COUNT_INTENSITY, COUNT_INTENSITY, 0, 0,
   COUNT_INTENSITY, COUNT_INTENSITY, COUNT_INTENSITY, 0, 0, 0,
   QCR_DELAY},
  {COUNT_INTENSITY, COUNT_INTENSITY, COUNT_INTENSITY, COUNT_INTENSITY, 0, 0,
   COUNT_INTENSITY, COUNT_INTENSITY, COUNT_INTENSITY, COUNT_INTENSITY, 0, 0,
   QCR_DELAY},
  {COUNT_INTENSITY, COUNT_INTENSITY, COUNT_INTENSITY, COUNT_INTENSITY, COUNT_INTENSITY, 0,
   COUNT_INTENSITY, COUNT_INTENSITY, COUNT_INTENSITY, COUNT_INTENSITY, 0, 0,
   QCR_DELAY},
  {COUNT_INTENSITY, COUNT_INTENSITY, COUNT_INTENSITY, COUNT_INTENSITY, COUNT_INTENSITY, 0,
   COUNT_INTENSITY, COUNT_INTENSITY, COUNT_INTENSITY, COUNT_INTENSITY, COUNT_INTENSITY, 0,
   QCR_DELAY},
  {COUNT_INTENSITY, COUNT_INTENSITY, COUNT_INTENSITY, COUNT_INTENSITY, COUNT_INTENSITY, COUNT_INTENSITY,
   COUNT_INTENSITY, COUNT_INTENSITY, COUNT_INTENSITY, COUNT_INTENSITY, COUNT_INTENSITY, 0,
   QCR_DELAY},
  {COUNT_INTENSITY, COUNT_INTENSITY, COUNT_INTENSITY, COUNT_INTENSITY, COUNT_INTENSITY, COUNT_INTENSITY,
   COUNT_INTENSITY, COUNT_INTENSITY, COUNT_INTENSITY, COUNT_INTENSITY, COUNT_INTENSITY, COUNT_INTENSITY,
   QCR_DELAY},
  {COUNT_INTENSITY, COUNT_INTENSITY, COUNT_INTENSITY, COUNT_INTENSITY, COUNT_INTENSITY, COUNT_INTENSITY,
   COUNT_INTENSITY, COUNT_INTENSITY, COUNT_INTENSITY, COUNT_INTENSITY, COUNT_INTENSITY, COUNT_INTENSITY,
   QCR_DELAY},
  {COUNT_INTENSITY, COUNT_INTENSITY, COUNT_INTENSITY, COUNT_INTENSITY, COUNT_INTENSITY, COUNT_INTENSITY,
   COUNT_INTENSITY, COUNT_INTENSITY, COUNT_INTENSITY, COUNT_INTENSITY, COUNT_INTENSITY, 0,
   QCR_DELAY},
  {COUNT_INTENSITY, COUNT_INTENSITY, COUNT_INTENSITY, COUNT_INTENSITY, COUNT_INTENSITY, 0,
   COUNT_INTENSITY, COUNT_INTENSITY, COUNT_INTENSITY, COUNT_INTENSITY, COUNT_INTENSITY, 0,
   QCR_DELAY},
  {COUNT_INTENSITY, COUNT_INTENSITY, COUNT_INTENSITY, COUNT_INTENSITY, COUNT_INTENSITY, 0,
   COUNT_INTENSITY, COUNT_INTENSITY, COUNT_INTENSITY, COUNT_INTENSITY, 0, 0,
   QCR_DELAY},
  {COUNT_INTENSITY, COUNT_INTENSITY, COUNT_INTENSITY, COUNT_INTENSITY, 0, 0,
   COUNT_INTENSITY, COUNT_INTENSITY, COUNT_INTENSITY, COUNT_INTENSITY, 0, 0,
   QCR_DELAY},
  {COUNT_INTENSITY, COUNT_INTENSITY, COUNT_INTENSITY, COUNT_INTENSITY, 0, 0,
   COUNT_INTENSITY, COUNT_INTENSITY, COUNT_INTENSITY, 0, 0, 0,
   QCR_DELAY},
  {COUNT_INTENSITY, COUNT_INTENSITY, COUNT_INTENSITY, 0, 0, 0,
   COUNT_INTENSITY, COUNT_INTENSITY, COUNT_INTENSITY, 0, 0, 0,
   QCR_DELAY},
  {COUNT_INTENSITY, COUNT_INTENSITY, COUNT_INTENSITY, 0, 0, 0,
   COUNT_INTENSITY, COUNT_INTENSITY, 0, 0, 0, 0,
   QCR_DELAY},
  {COUNT_INTENSITY, COUNT_INTENSITY, 0, 0, 0, 0,
   COUNT_INTENSITY, COUNT_INTENSITY, 0, 0, 0, 0,
   QCR_DELAY},
  {COUNT_INTENSITY, COUNT_INTENSITY, 0, 0, 0, 0,
   COUNT_INTENSITY, 0, 0, 0, 0, 0,
   QCR_DELAY},
  {COUNT_INTENSITY, 0, 0, 0, 0, 0,
   COUNT_INTENSITY, 0, 0, 0, 0, 0,
   QCR_DELAY},
  {COUNT_INTENSITY, 0, 0, 0, 0, 0,
   0, 0, 0, 0, 0, 0,
   QCR_DELAY},
}; //badgecount

// Uber count:
#define QCR_DELAY 150
#define UBERCOUNTLEN 21
QCRing ubercount[] PROGMEM = {
  {0, 0, 0, 0, 0, 0,
   0, 0, 0, 0, 0, 0,
   QCR_DELAY},
  {0, 0, 0, 0, 0, 0,
   UBER_DIM, 0, 0, UBER_DIM, 0, 0,
   QCR_DELAY},
  {0, UBER_DIM, 0, 0, UBER_DIM, 0,
   UBER_DIM, 0, 0, UBER_DIM, 0, 0,
   QCR_DELAY},
  {0, UBER_DIM, 0, 0, UBER_DIM, 0,
   UBER_DIM, UBER_DIM, 0, UBER_DIM, UBER_DIM, 0,
   QCR_DELAY},
  {0, UBER_DIM, UBER_DIM, 0, UBER_DIM, UBER_DIM,
   UBER_DIM, UBER_DIM, 0, UBER_DIM, UBER_DIM, 0,
   QCR_DELAY},
  {0, UBER_DIM, UBER_DIM, 0, UBER_DIM, UBER_DIM,
   UBER_DIM, UBER_DIM, UBER_DIM, UBER_DIM, UBER_DIM, UBER_DIM,
   QCR_DELAY},
  {0, UBER_DIM, UBER_DIM, 0, UBER_DIM, UBER_DIM,
   COUNT_INTENSITY, UBER_DIM, UBER_DIM, UBER_DIM, UBER_DIM, UBER_DIM,
   QCR_DELAY},
  {0, UBER_DIM, UBER_DIM, 0, UBER_DIM, UBER_DIM,
   COUNT_INTENSITY, UBER_DIM, UBER_DIM, COUNT_INTENSITY, UBER_DIM, UBER_DIM,
   QCR_DELAY},
  {0, COUNT_INTENSITY, UBER_DIM, 0, UBER_DIM, UBER_DIM,
   COUNT_INTENSITY, UBER_DIM, UBER_DIM, COUNT_INTENSITY, UBER_DIM, UBER_DIM,
   QCR_DELAY},
  {0, COUNT_INTENSITY, UBER_DIM, 0, COUNT_INTENSITY, UBER_DIM,
   COUNT_INTENSITY, UBER_DIM, UBER_DIM, COUNT_INTENSITY, UBER_DIM, UBER_DIM,
   QCR_DELAY},
  {0, COUNT_INTENSITY, UBER_DIM, 0, COUNT_INTENSITY, UBER_DIM,
   COUNT_INTENSITY, COUNT_INTENSITY, UBER_DIM, COUNT_INTENSITY, UBER_DIM, UBER_DIM,
   QCR_DELAY},
  {0, COUNT_INTENSITY, UBER_DIM, 0, COUNT_INTENSITY, UBER_DIM,
   COUNT_INTENSITY, COUNT_INTENSITY, UBER_DIM, COUNT_INTENSITY, COUNT_INTENSITY, UBER_DIM,
   QCR_DELAY},
  {0, COUNT_INTENSITY, COUNT_INTENSITY, 0, COUNT_INTENSITY, UBER_DIM,
   COUNT_INTENSITY, COUNT_INTENSITY, UBER_DIM, COUNT_INTENSITY, COUNT_INTENSITY, UBER_DIM,
   QCR_DELAY},
  {0, COUNT_INTENSITY, COUNT_INTENSITY, 0, COUNT_INTENSITY, COUNT_INTENSITY,
   COUNT_INTENSITY, COUNT_INTENSITY, UBER_DIM, COUNT_INTENSITY, COUNT_INTENSITY, UBER_DIM,
   QCR_DELAY},
  {0, COUNT_INTENSITY, COUNT_INTENSITY, 0, COUNT_INTENSITY, COUNT_INTENSITY,
   COUNT_INTENSITY, COUNT_INTENSITY, COUNT_INTENSITY, COUNT_INTENSITY, COUNT_INTENSITY, UBER_DIM,
   QCR_DELAY},
  {0, COUNT_INTENSITY, COUNT_INTENSITY, 0, COUNT_INTENSITY, COUNT_INTENSITY,
   COUNT_INTENSITY, COUNT_INTENSITY, COUNT_INTENSITY, COUNT_INTENSITY, COUNT_INTENSITY, COUNT_INTENSITY,
   QCR_DELAY},
  {0, 0, 0, 0, 0, 0,
   0, 0, 0, 0, 0, 0,
   50},
  {COUNT_INTENSITY, COUNT_INTENSITY, COUNT_INTENSITY, COUNT_INTENSITY, COUNT_INTENSITY, COUNT_INTENSITY,
   0, 0, 0, 0, 0, 0,
   500},
  {0, 0, 0, 0, 0, 0,
   COUNT_INTENSITY, COUNT_INTENSITY, COUNT_INTENSITY, COUNT_INTENSITY, COUNT_INTENSITY, COUNT_INTENSITY,
   500},
  {0, 0, 0, 0, 0, 0,
   0, 0, 0, 0, 0, 0,
   50}
}; //ubercount

// Blank the ring:
#define BLANKLEN 2
QCRing blankring[] PROGMEM = {
  {0, 0, 0, 0, 0, 0,
   0, 0, 0, 0, 0, 0,
   1000},
  {0, 0, 0, 0, 0, 0,
   0, 0, 0, 0, 0, 0,
   1000}
}; //blank

QCRing *ring_animations[] = {&bling1, &bling2, &bling3, &bling4, &bling5, 
                             &bling6, &bling7, &bling8, &bling9, &bling10,
                             &ubling1, &ubling2, &ubling3, &ubling4, &ubling5,
                             &ubling6, &ubling7, &ubling8, &ubling9, &ubling10,
                             &uber1, &uber2, &uber3, &uber4, &uber5,
                             &uber6, &uber7, &uber8, &uber9, &uber10,
                             &newbadge, &nearbadge, &badgecount, &superuber,
                             &ubercount, &blankring};
uint8_t ring_anim_lengths[] = {BLING1LEN, BLING2LEN, BLING3LEN, BLING4LEN, BLING5LEN,
                               BLING6LEN, BLING7LEN, BLING8LEN, BLING9LEN, BLING10LEN,
                               UBLING1LEN, UBLING2LEN, UBLING3LEN, UBLING4LEN, UBLING5LEN,
                               UBLING6LEN, UBLING7LEN, UBLING8LEN, UBLING9LEN, UBLING10LEN,
                               UBER1LEN, UBER2LEN, UBER3LEN, UBER4LEN, UBER5LEN,
                               UBER6LEN, UBER7LEN, UBER8LEN, UBER9LEN, UBER10LEN,
                               NEWBADGELEN, NEARBADGELEN, BADGECOUNTLEN, SUPERUBERLEN,
                               UBERCOUNTLEN, BLANKLEN};

// For blinking:
QCRing qcr_blinky_short = {
  0, 0, 0, 0, 0, 0,
  0, 0, 0, 0, 0, 0,
  90};
QCRing qcr_blinky_long = {
  0, 0, 0, 0, 0, 0,
  0, 0, 0, 0, 0, 0,
  750};
QCRing qcr_ubercount_blinky = {
  0, UBER_DIM, UBER_DIM, 0, UBER_DIM, UBER_DIM,
  UBER_DIM, UBER_DIM, UBER_DIM, UBER_DIM, UBER_DIM, UBER_DIM,
  90};
