duplico/qc10/tlc5940.h

/*

  tlc5940.h

  Copyright 2010-2011 Matthew T. Pandina. All rights reserved.

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
  1. Redistributions of source code must retain the above copyright notice,
  this list of conditions and the following disclaimer.

  2. Redistributions in binary form must reproduce the above copyright notice,
  this list of conditions and the following disclaimer in the documentation
  and/or other materials provided with the distribution.

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
*/

#pragma once
#include "main.h"

#include <stdint.h>
#include <avr/io.h>

#if (TLC5940_INCLUDE_GAMMA_CORRECT)
#include <avr/pgmspace.h>
#endif // TLC5940_INCLUDE_GAMMA_CORRECT

// These options are not configurable because they rely on specific hardware
// features of the ATmega328P that are only available on specific pins.
#if (TLC5940_USART_MSPIM)
#define SIN_DDR DDRD
#define SIN_PORT PORTD
#define SIN_PIN PD1

#define SCLK_DDR DDRD
#define SCLK_PORT PORTD
#define SCLK_PIN PD4
#else // TLC5940_USART_MSPIM
#define SIN_DDR DDRB
#define SIN_PORT PORTB
#define SIN_PIN PB3

#define SCLK_DDR DDRB
#define SCLK_PORT PORTB
#define SCLK_PIN PB5

#define BLANK_DDR DDRB
#define BLANK_PORT PORTB
#define BLANK_PIN PB2
#endif // TLC5940_USART_MSPIM

// --------------------------------------------------------

#define setOutput(ddr, pin) ((ddr) |= (1 << (pin)))
#define setLow(port, pin) ((port) &= ~(1 << (pin)))
#define setHigh(port, pin) ((port) |= (1 << (pin)))
#define getValue(port, pin) ((port) & (1 << (pin)))
#define pulse(port, pin) do {                       \
                           setHigh((port), (pin));  \
                           setLow((port), (pin));   \
                         } while (0)

#if (24 * TLC5940_N > 255)
#define gsData_t uint16_t
#else
#define gsData_t uint8_t
#endif

#if (16 * TLC5940_N > 255)
#define channel_t uint16_t
#else
#define channel_t uint8_t
#endif

#if (3 * 16 * TLC5940_N > 255)
#define channel3_t uint16_t
#else
#define channel3_t uint8_t
#endif

#if (24 * TLC5940_N * TLC5940_MULTIPLEX_N > 255)
#define gsOffset_t uint16_t
#else
#define gsOffset_t uint8_t
#endif

#define gsDataSize ((gsData_t)24 * TLC5940_N)
#define numChannels ((channel_t)16 * TLC5940_N)

#if (TLC5940_ENABLE_MULTIPLEXING)
extern uint8_t toggleRows[TLC5940_MULTIPLEX_N];
extern uint8_t gsData[TLC5940_MULTIPLEX_N][gsDataSize];
extern uint8_t *pBack;
#else // TLC5940_ENABLE_MULTIPLEXING
extern uint8_t gsData[gsDataSize];
#endif // TLC5940_ENABLE_MULTIPLEXING

#if (TLC5940_USE_GPIOR0)
#define TLC5940_FLAGS GPIOR0
// gsUpdateFlag is now a convenience macro so client code can remain unchanged
#define gsUpdateFlag (getValue(TLC5940_FLAGS, TLC5940_FLAG_GS_UPDATE))
#else // TLC5940_USE_GPIOR0
extern volatile uint8_t gsUpdateFlag;
#endif // TLC5940_USE_GPIOR0

#if (TLC5940_INCLUDE_GAMMA_CORRECT)
extern uint16_t TLC5940_GammaCorrect[] PROGMEM;
#endif // TLC5940_INCLUDE_GAMMA_CORRECT

static inline void TLC5940_SetGSUpdateFlag(void) {
  __asm__ volatile ("" ::: "memory");
#if (TLC5940_USE_GPIOR0)
  setHigh(TLC5940_FLAGS, TLC5940_FLAG_GS_UPDATE);
#else // TLC5940_USE_GPIOR0
  gsUpdateFlag = 1;
#endif // TLC5940_USE_GPIOR0
  __asm__ volatile ("" ::: "memory");
}

#if (TLC5940_INCLUDE_DC_FUNCS)
#if (12 * TLC5940_N > 255)
#define dcData_t uint16_t
#else
#define dcData_t uint8_t
#endif

#define dcDataSize ((dcData_t)12 * TLC5940_N)

extern uint8_t dcData[dcDataSize];

void TLC5940_SetDC(channel_t channel, uint8_t value);
void TLC5940_SetAllDC(uint8_t value);
#if (TLC5940_INCLUDE_SET4_FUNCS)
void TLC5940_Set4DC(channel_t channel, uint8_t value);
#endif // TLC5940_INCLUDE_SET4_FUNCS
void TLC5940_ClockInDC(void);
#endif // TLC5940_INCLUDE_DC_FUNCS

#if (TLC5940_ENABLE_MULTIPLEXING)
#if (TLC5940_INLINE_SETGS_FUNCS)
static inline void TLC5940_SetGS(uint8_t row, channel_t channel, uint16_t value) __attribute__(( always_inline ));
static inline void TLC5940_SetGS(uint8_t row, channel_t channel, uint16_t value) {
#else // TLC5940_INLINE_SETGS_FUNCS
static        void TLC5940_SetGS(uint8_t row, channel_t channel, uint16_t value) {
#endif // TLC5940_INLINE_SETGS_FUNCS
  channel = numChannels - 1 - channel;
  uint16_t offset = (uint16_t)((channel3_t)channel * 3 / 2) + (gsOffset_t)gsDataSize * row;

  switch (channel % 2) {
  case 0:
    *(pBack + offset++) = (value >> 4);
    *(pBack + offset) = (*(pBack + offset) & 0x0F) | (uint8_t)(value << 4);
    break;
  default: // case 1:
    *(pBack + offset) = (*(pBack + offset) & 0xF0) | (value >> 8);
    *(pBack + ++offset) = (uint8_t)value;
    break;
  }
}
#else // TLC5940_ENABLE_MULTIPLEXING
#if (TLC5940_INLINE_SETGS_FUNCS)
static inline void TLC5940_SetGS(channel_t channel, uint16_t value) __attribute__(( always_inline ));
static inline void TLC5940_SetGS(channel_t channel, uint16_t value) {
#else // TLC5940_INLINE_SETGS_FUNCS
static        void TLC5940_SetGS(channel_t channel, uint16_t value) {
#endif // TLC5940_INLINE_SETGS_FUNCS
  channel = numChannels - 1 - channel;
  channel3_t i = (channel3_t)channel * 3 / 2;

  switch (channel % 2) {
  case 0:
    gsData[i++] = (value >> 4);
    gsData[i] = (gsData[i] & 0x0F) | (uint8_t)(value << 4);
    break;
  default: // case 1:
    gsData[i] = (gsData[i] & 0xF0) | (value >> 8);
    gsData[++i] = (uint8_t)value;
    break;
  }
}
#endif // TLC5940_ENABLE_MULTIPLEXING

#if (TLC5940_ENABLE_MULTIPLEXING)
#if (TLC5940_INLINE_SETGS_FUNCS)
static inline void TLC5940_SetAllGS(uint8_t row, uint16_t value) __attribute__(( always_inline ));
static inline void TLC5940_SetAllGS(uint8_t row, uint16_t value) {
#else // TLC5940_INLINE_SETGS_FUNCS
static        void TLC5940_SetAllGS(uint8_t row, uint16_t value) {
#endif // TLC5940_INLINE_SETGS_FUNCS
  uint8_t tmp1 = (value >> 4);
  uint8_t tmp2 = (uint8_t)(value << 4) | (tmp1 >> 4);

  gsOffset_t offset = (gsOffset_t)gsDataSize * row;
  gsData_t i = gsDataSize / 3 + 1;
  while (--i) {
    *(pBack + offset++) = tmp1;              // bits: 11 10 09 08 07 06 05 04
    *(pBack + offset++) = tmp2;              // bits: 03 02 01 00 11 10 09 08
    *(pBack + offset++) = (uint8_t)value;    // bits: 07 06 05 04 03 02 01 00
  }
}
#else // TLC5940_ENABLE_MULTIPLEXING
#if (TLC5940_INLINE_SETGS_FUNCS)
static inline void TLC5940_SetAllGS(uint16_t value) __attribute__(( always_inline ));
static inline void TLC5940_SetAllGS(uint16_t value) {
#else // TLC5940_INLINE_SETGS_FUNCS
static        void TLC5940_SetAllGS(uint16_t value) {
#endif // TLC5940_INLINE_SETGS_FUNCS
  uint8_t tmp1 = (value >> 4);
  uint8_t tmp2 = (uint8_t)(value << 4) | (tmp1 >> 4);

  gsData_t i = 0;
  do {
    gsData[i++] = tmp1;              // bits: 11 10 09 08 07 06 05 04
    gsData[i++] = tmp2;              // bits: 03 02 01 00 11 10 09 08
    gsData[i++] = (uint8_t)value;    // bits: 07 06 05 04 03 02 01 00
  } while (i < gsDataSize);
}
#endif // TLC5940_ENABLE_MULTIPLEXING

#if (TLC5940_INCLUDE_SET4_FUNCS)
#if (TLC5940_ENABLE_MULTIPLEXING)
// Assumes that outputs 0-3, 4-7, 8-11, 12-15 of the TLC5940 have
// been connected together to sink more current. For a single
// TLC5940, the parameter 'channel' should be in the range 0-3
#if (TLC5940_INLINE_SETGS_FUNCS)
static inline void TLC5940_Set4GS(uint8_t row, channel_t channel, uint16_t value) __attribute__(( always_inline ));
static inline void TLC5940_Set4GS(uint8_t row, channel_t channel, uint16_t value) {
#else // TLC5940_INLINE_SETGS_FUNCS
static        void TLC5940_Set4GS(uint8_t row, channel_t channel, uint16_t value) {
#endif // TLC5940_INLINE_SETGS_FUNCS
  channel = numChannels - 1 - (channel * 4) - 3;
  uint16_t offset = (uint16_t)((channel3_t)channel * 3 / 2) + (gsOffset_t)gsDataSize * row;

  uint8_t tmp1 = (value >> 4);
  uint8_t tmp2 = (uint8_t)(value << 4) | (tmp1 >> 4);

  *(pBack + offset++) = tmp1;              // bits: 11 10 09 08 07 06 05 04
  *(pBack + offset++) = tmp2;              // bits: 03 02 01 00 11 10 09 08
  *(pBack + offset++) = (uint8_t)value;    // bits: 07 06 05 04 03 02 01 00
  *(pBack + offset++) = tmp1;              // bits: 11 10 09 08 07 06 05 04
  *(pBack + offset++) = tmp2;              // bits: 03 02 01 00 11 10 09 08
  *(pBack + offset) = (uint8_t)value;      // bits: 07 06 05 04 03 02 01 00
}
#else // TLC5940_ENABLE_MULTIPLEXING
// Assumes that outputs 0-3, 4-7, 8-11, 12-15 of the TLC5940 have
// been connected together to sink more current. For a single
// TLC5940, the parameter 'channel' should be in the range 0-3
#if (TLC5940_INLINE_SETGS_FUNCS)
static inline void TLC5940_Set4GS(channel_t channel, uint16_t value) __attribute__(( always_inline ));
static inline void TLC5940_Set4GS(channel_t channel, uint16_t value) {
#else // TLC5940_INLINE_SETGS_FUNCS
static        void TLC5940_Set4GS(channel_t channel, uint16_t value) {
#endif // TLC5940_INLINE_SETGS_FUNCS
  channel = numChannels - 1 - (channel * 4) - 3;
  channel3_t i = (channel3_t)channel * 3 / 2;

  uint8_t tmp1 = (value >> 4);
  uint8_t tmp2 = (uint8_t)(value << 4) | (tmp1 >> 4);

  gsData[i++] = tmp1;              // bits: 11 10 09 08 07 06 05 04
  gsData[i++] = tmp2;              // bits: 03 02 01 00 11 10 09 08
  gsData[i++] = (uint8_t)value;    // bits: 07 06 05 04 03 02 01 00
  gsData[i++] = tmp1;              // bits: 11 10 09 08 07 06 05 04
  gsData[i++] = tmp2;              // bits: 03 02 01 00 11 10 09 08
  gsData[i] = (uint8_t)value;      // bits: 07 06 05 04 03 02 01 00
}
#endif // TLC5940_ENABLE_MULTIPLEXING
#endif // TLC5940_INCLUDE_SET4_FUNCS

void TLC5940_ClockInGS(void);
void TLC5940_Init(void);
