duplico/qc10/(commit log)

2012-12-14 Switch groups when sending, but back to non-working.
2013-07-02 Add the basic LED control code.
2013-07-03 Adjust LED code to accept suitable QC badge style definitions.
2013-07-09 Fix radio config settings.
    [qc10badge.ino]
2013-07-16 Use TIMER2 instead of TIMER0 for the LEDs, to avoid conflicts.
    [tlc5940.c]
2013-07-16 Alter the delay scheme to avoid busy waiting for the LED control.
    [main.c, main.h, qc10badge.ino]
2013-07-19 Configure LED communication for production-wired badges.
2013-07-19 Add the ability to control whether we compile in LED code or not.
2013-07-19 Minor cleanup. Comment out prints.
2013-07-20 Resolve myself to believing that the delay is "delay until", not "delay after".
    [animations.c, qc10badge.ino]
2013-07-23 Add the structure to permit blinking on arbitrary frames.
2013-07-23 Add a lot of the counting influence on LEDs.
2013-07-23 Implement gaydar control of LEDs.
2013-07-23 Clean up TODOs. Minor fixes. Needs refactoring.
    [animations.c, main.c, main.h, qc10badge.ino]
2013-07-26 Refactor idle timing to have a better flow for preboot/postboot.
2013-07-26 Try adding some code for free-running the ADC with the microphone on it.
2013-07-26 Back to working, plus some cruft code. Hang tight.
    [main.c, qc10badge.ino]
2013-07-26 Add occasional badge count showing mechanism. Too much activity.
    [animations.c, animations.h, qc10badge.ino]
2013-07-26 Calling it a night. Still badge counting problems and radio interval problems.
    [qc10badge.ino]
2013-07-26 Backoff amplifier gain in the event that we fail to transmit a message.
    [qc10badge.ino]
2013-07-27 Increase gaydar reliability. Partial fix of badge count.
    [qc10badge.ino]
2013-07-27 Fix party time so that it ends uber idle animations.
    [animations.c, qc10badge.ino]
2013-07-27 Attempted fix of neighbor/new badge display misordering.
    [qc10badge.ino]
2013-07-27 Adjust badge loading. More work to prevent animations in party mode.
    [qc10badge.ino]
2013-07-27 Adjust heartbeat setting code to try to resolve #2.
    [qc10badge.ino]
2013-07-27 Disable dot correction, which I wasn't really using anyway.
    [main.h]
2013-07-27 Begin refactoring LED control functions.
2013-07-27 Significant refactoring of LED subsystem.
2013-07-27 Don't switch heartbeats in party mode.
2013-07-28 Pick a random color to flash for a party, at boot time. Resolve #7.
    [animations.c, qc10badge.ino]
2013-07-28 Correction to random color picking.
    [qc10badge.ino]
2013-07-28 Enable/disable ADC depending on whether we need to be listening or not.
2013-07-28 This is just. The stupidest. Problem. Ever. COUNT, DAMN YOU.
    [animations.c, qc10badge.ino]
2013-07-28 Avoid inappropriately showing the "newly nearby badge" notification.
    [qc10badge.ino]
2013-07-28 Correct intervals due to the ISR using centiseconds, not milliseconds.
    [main.c]
2013-07-28 Don't cut off my party!
2013-07-28 Add some documentation.
    [QC10 BOM.xlsx]
2013-07-29 Correct the badge count and uberfade logic.
    [animations.c, main.c, qc10badge.ino]
2013-07-29 Remove the receive blink, resolving #14. Fix the fade on counts.
    [qc10badge.ino]
2013-07-29 Make the party time more cromulent. Resolves #16.
    [main.c]
2016-08-03 Ignore stuff, turn LEDs back on.
